saulius1005/AVR64DD32-MAIN-Controller/AVR64DD32-MAIN-Controller/StepperMotor.c

/*
 * StepperMotor.c
 *
 * Created: 2025-09-11 10:29:21
 *  Author: Saulius
 */ 
#include "Settings.h"
#include "StepperMotorVar.h"

// -------------------------
// Notice
// -------------------------
// for CL86T need swap encoder pair lines 
// -------------------------
// 86HB250-156B MOTOR		CL86T 4.1
// -------------------------
// EA+						EB+			
// EA-						EB-
// EB+						EA+
// EB-						EA-
// -------------------------

// -------------------------
// Stepper Enable / Disable
// -------------------------
void Stepper_enable() {
	if(StepperMotor.alreadyEnabled == false){
		PORTF.OUTCLR = PIN1_bm; // aktyvus LOW
		_delay_ms(300); //recomended min 200m
		StepperMotor.alreadyEnabled = true;
		StepperMotor.alreadyDisabled = false;
	}
}

void Stepper_disable() {
	if(StepperMotor.alreadyDisabled == false){
		PORTF.OUTSET = PIN1_bm; // HIGH = inactive
		_delay_ms(300); //recomended min 200m
		StepperMotor.alreadyDisabled = true;
		StepperMotor.alreadyEnabled = false;
	}
}

// -------------------------
// Stepper Start / Stop
// -------------------------
void Stepper_start() {
	if(StepperMotor.alreadyStarted == false){
		while (!(TCD0.STATUS & TCD_ENRDY_bm));
		TCD0.CTRLA |= TCD_ENABLE_bm;
		StepperMotor.alreadyStarted = true;
		StepperMotor.alreadyStoped = false;
	}
}


void Stepper_stop() {
	if(StepperMotor.alreadyStoped == false){
		while (!(TCD0.STATUS & TCD_ENRDY_bm));//
		TCD0.CTRLA &= ~TCD_ENABLE_bm;//disable counter
		StepperMotor.alreadyStoped = true;
		StepperMotor.alreadyStarted = false;
	}
}

// -------------------------
// Stepper Direction
// -------------------------
void Stepper_set_direction(bool dir) {
	if (dir != StepperMotor.lastDirection)  // if direction change (single time per cycle)
	{
		Stepper_stop();//Stop generating pulses
		if (dir)
			PORTF.OUTSET = PIN3_bm;
		else
			PORTF.OUTCLR = PIN3_bm;
		_delay_us(3); //recomended min 2us
		Stepper_start();// start generating pulses
		StepperMotor.lastDirection = dir;
	}
}

// -------------------------
// Init function
// -------------------------
void Stepper_init() {

	// Default PWM
	TCD0_init_stepper_PWM(25600, 50); // 51.2kHz, 50% duty for one motor shaft spin, so ~20s for gearbox
/*
	// Set idle states
	PORTF.OUTCLR = PIN2_bm; // pulse low
	PORTF.OUTSET = PIN1_bm; // disable
	PORTF.OUTCLR = PIN3_bm; // default direction*/
}

bool Read_Stepper_PEND(){ // true if position reached
	return !(PORTF.IN & PIN5_bm);
}

bool Read_Stepper_ALM(){ // true if driver has a error (overheat, stepepr stuck and so on)
	return !(PORTF.IN & PIN4_bm);
}

uint16_t Read_Stepper_Voltage(){
	ADC0_SetupStepper(0);
	return (ADC0_read() * 0.1775) * Stepper_Voltage_Compensation_koef;
}

int16_t Read_Stepper_Current(){
	ADC0_SetupStepper(1);
	return ((int16_t)ADC0_read() - (int16_t)Read_MCU_Voltge())/4;
}
