saulius1005/AVR64DD32-MAIN-Controller/AVR64DD32-MAIN-Controller/LinearMotor.c

/*
 * LinearMotor.c
 *
 * Created: 2025-09-09 14:20:10
 *  Author: Saulius
 */ 
#include "Settings.h"
#include "LinearMotorVar.h"

void LinearMotor_enable(){ //turn on TLE9201SG
	if(LinearMotor.alreadyEnabled == false){
		PORTD.OUTCLR = PIN2_bm;  // DIS=0
		_delay_us(5);
		LinearMotor.alreadyEnabled = true;
		LinearMotor.alreadyDisabled = false;
	}
}

void LinearMotor_disable(){ //turn off TLE9201SG
	if(LinearMotor.alreadyDisabled == false){
		PORTD.OUTSET = PIN2_bm;  // DIS=1
		_delay_us(5);
		LinearMotor.alreadyDisabled = true;
		LinearMotor.alreadyEnabled = false;
	}
}

void LinearMotor_start(){ //starting pwm signal generation
	if(LinearMotor.alreadyStarted == false){		
		TCA0.SPLIT.CTRLB |= TCA_SPLIT_HCMP0EN_bm; //connecting TCA to PD3
		TCA0.SPLIT.CTRLA |= TCA_SPLIT_ENABLE_bm; //turn on TCA back
		LinearMotor.alreadyStarted = true;
		LinearMotor.alreadyStoped = false;
	}

}

void LinearMotor_stop(){
	if(LinearMotor.alreadyStoped == false){ //stoping pwm signal generation
		TCA0.SPLIT.CTRLB &= ~(TCA_SPLIT_HCMP0EN_bm); //disconecting TCA from PD3
		TCA0.SPLIT.CTRLA &= ~TCA_SPLIT_ENABLE_bm;  // turn off TCA
		PORTD.OUTCLR = PIN3_bm; //ensure PWM low level
		_delay_ms(500); //preventing from error flag- 500mS of free spinning
		LinearMotor.alreadyStoped = true;
		LinearMotor.alreadyStarted = false;
	}

}

void LinearMotor_set_direction(bool dir)
{
    if (dir != LinearMotor.lastDirection)  // if direction change (single time per cycle)
    {
		LinearMotor_stop();
		if(dir)
            PORTD.OUTSET = PIN5_bm;   // UP
		else
            PORTD.OUTCLR = PIN5_bm;   // DOWN
		_delay_us(5);
		LinearMotor_start();
        LinearMotor.lastDirection = dir;
    }
}

void LinearMotor_init(){
	TCA0_init_linear_PWM(20000, 95);
	PORTD.OUTSET = PIN2_bm; //set output disabled for TLE9201SG
};

bool Read_LinearMotor_EF(){ // false if driver has a error (overheat, linear motor stuck and so on)
	return PORTD.IN & PIN4_bm;
}

uint16_t Read_LinearMotor_Voltage(){
	ADC0_SetupLinearMotor(0);
	return (ADC0_read() * 0.075) * LinearMotor_Voltage_Compensation_koef; // same as ADC read/2000 * 30V (300k) / 2V(AMC1131 full range) )
}

int16_t Read_LinearMotor_Current(){
	ADC0_SetupLinearMotor(1);
	return ((int16_t)ADC0_read() - (int16_t)Read_MCU_Voltge())/4;
}
