saulius1005/AVR64DD32-MAIN-Controller/AVR64DD32-MAIN-Controller/StepperMotor.h

/*
 * StepperMotor.h
 *
 * Created: 2025-09-11 10:30:32
 *  Author: Saulius
 */ 


#ifndef STEPPERMOTOR_H_
#define STEPPERMOTOR_H_

#define Stepper_Voltage_Compensation_koef 1.05 //59,62V Actual measured voltage and calculated 56,7V

typedef struct {
	bool lastDirection;
	bool alreadyStarted;
	bool alreadyStoped;
	bool alreadyEnabled;
	bool alreadyDisabled;
	uint16_t measuredVoltage;
	int16_t measuredCurrent;
	uint8_t stuckCount;
	uint8_t noChangeCount;
} HBS86;

extern HBS86 StepperMotor;


#endif /* STEPPERMOTOR_H_ */
