saulius1005/AVR64DD32-MAIN-Controller/AVR64DD32-MAIN-Controller/LinearMotorVar.h

/*
 * LinearMotorVar.h
 *
 * Created: 2025-09-09 14:37:56
 *  Author: Saulius
 */ 


#ifndef LINEARMOTORVAR_H_
#define LINEARMOTORVAR_H_

TLE9201SG LinearMotor = {
	.lastDirection = false,
	.alreadyStarted = false,
	.alreadyStoped = false,
	.alreadyEnabled = false,
	.alreadyDisabled = false,
	.measuredVoltage = 0,
	.measuredCurrent = 0,
	.stuckCount = 0,
	.noChangeCount = 0
};

#endif /* LINEARMOTORVAR_H_ */
