saulius1005/AVR64DD32-MAIN-Controller/AVR64DD32-MAIN-Controller/FOUSART.h

/*
 * FOUSART.h
 *
 * Created: 2025-09-05 11:21:40
 *  Author: Saulius
 */ 


#ifndef FOUSART_H_
#define FOUSART_H_

/**
 * @brief Maximum count for consecutive errors before marking the system as faulty.
 */
#define FO_TIMEOUT_COUNTER 400000 ///< Timeout counter value for operations if baud 460.8k
#define CountForError_FO 3
#define Angle_Precizion 100 // 100 meaning exp. 360 degree 10 3600 (360,0), 1 36000 (360,00)
#define U_I_Precizion 1 // 10 meaning 24, 1 240 (24.0)
#define MESSAGE_LENGTH_FO 17


typedef struct {
	uint16_t Elevation;
	uint16_t HPElevation;
	uint16_t Azimuth;
	uint16_t HPAzimuth;
	uint16_t PVU;
	uint16_t PVI;
	uint8_t endSwitches;
	bool ElMin;
	bool ElMax;
	bool AzMin;
	bool AzMax;
	bool FO_bad_signal_fault;
	bool FO_lost_signal_fault;
	bool FO_data_fault;
	bool FO_lost_connecton_fault;
	uint8_t FO_elevation_sensor_fault;
	uint8_t FO_azimuth_sensor_fault;
	uint8_t FO_faultcount;
	char FreshDataPack[MESSAGE_LENGTH_FO];
} FOdata;

extern FOdata SensorData;

#endif /* FOUSART_H_ */
