saulius1005/AVR64DD32-MAIN-Controller/AVR64DD32-MAIN-Controller/i2c.h

/**
 * @file i2c.h
 * @brief Header file for I2C Communication Functions
 * 
 * This header file defines constants, macros, and function prototypes for I2C communication.
 * It also defines a structure for storing the I2C status, including error codes.
 * 
 * Created: 2024-12-05 14:29:10
 * Author: Saulius
 */

#ifndef I2C_H_
#define I2C_H_


#define F_SCL 400000UL 

#define TWI_TIMEOUT_COUNTER 5000 ///< Timeout counter value for operations

#define I2C_RETRY_COUNT 3

#define TWI_BAUD ((F_CPU / (2 * F_SCL)) - 5)

#define WRITE 0 ///< Write operation flag

#define READ 1 ///< Read operation flag

#define STOP 1 ///< Stop condition flag

#define Error_None    0
#define Error_Timeout 1
#define Error_NACK    2
#define Error_Bus     3

typedef struct {
    volatile uint8_t error; ///< Error code for I2C operations
} I2C_Status;

extern I2C_Status I2C; ///< Global I2C status instance

#endif /* I2C_H_ */
