saulius1005/AVR64DD32-MAIN-Controller/AVR64DD32-MAIN-Controller/Joystick.h

/*
 * Joystick.h
 *
 * Created: 2025-09-08 12:58:50
 *  Author: Saulius
 */ 


#ifndef JOYSTICK_H_
#define JOYSTICK_H_

#define Joystick_X_axis_CH ADC_MUXPOS_AIN30_gc //dependet  from GPIO.c settings
#define Joystick_Y_axis_CH ADC_MUXPOS_AIN29_gc //dependet  from GPIO.c settings
#define Joystick_steps 500 //how many steps in one axis. 1000 means 5 (4 + step at 0 = 5), exp: 500 = 9, 2000 = 3 and so on.

typedef struct {
	int16_t X_Axis;
	int16_t Y_Axis;
	uint8_t Button;
	bool LastState;
	uint8_t LatchSwitch;
	uint8_t window;
} ADCJoy;

extern ADCJoy Joystick;

#endif /* JOYSTICK_H_ */
