saulius1005/AVR64DD32-MAIN-Controller/AVR64DD32-MAIN-Controller/JoystickVar.h

/*
 * JoystickVar.h
 *
 * Created: 2025-09-08 12:59:06
 *  Author: Saulius
 */ 


#ifndef JOYSTICKVAR_H_
#define JOYSTICKVAR_H_

ADCJoy Joystick = {
	.X_Axis = 0,
	.Y_Axis = 0,
	.Button = 0,
	.LastState = false,
	.LatchSwitch = 0,
	.window = 0
};



#endif /* JOYSTICKVAR_H_ */
