saulius1005/AVR64DD32-MAIN-Controller/AVR64DD32-MAIN-Controller/windowsVar.h

/*
 * windowsVar.h
 *
 * Created: 2025-01-26 23:35:50
 *  Author: Saulius
 */ 


#ifndef WINDOWSVAR_H_
#define WINDOWSVAR_H_

screenShow show = {
	.window = 0,
	.lastWindow = 0
};

#endif /* WINDOWSVAR_H_ */
