saulius1005/AVR64DD32-MAIN-Controller/(commit log)

2025-09-07 Function test at first
    screen working, FO also, Attiny212 part working great, now filtering and processing received data from Top controller trough FO
2025-09-08 Joystick functions
    Added basic Joystick functions. Now MCU reads X, Y axis ADC values and also reads Button status. ADC don't work if Multivoltage pins are enabled in MCU fuses settings
2025-09-09 RS485 communication test
    First data receiving test and its work!!! through ~12m cable
2025-09-09 Linear motion test
    its work but with strange behavior. Need to found bug.
    [CLK.c, FOUSART.c, FOUSART.h, FOUSARTVar.h, GPIO.c, LinearMotor.c, LinearMotor.h, LinearMotorVar.h]
2025-09-09 linear motor test success
    bug found- after TCA disabling also need to disconect it from a PD3 pin and only then change direction. After that connect back PD3 and turn on TCA
    [LinearMotor.c, main.c]
2025-09-10 Linear motor action logic
    closed loop function already work, now need to fix a function version which one is not in closed loop (fault detection logic need to be fixed)
    [FOUSART.c, FOUSART.h, FOUSARTVar.h, LinearMotor.c, LinearMotor.h, LinearMotorVar.h, Settings.h]
2025-09-12 Stepper control
    Added and tested stepper control functions. It works at 40kHz using TCD timer HBS86 driver settings also is Pulse/rev = 40000
2025-09-12 Linear and Stepper basic functions completed
    Both linear (elevation) and stepper (azimuth) motors basic controlling functions are completed. enable, disable, start, stop, set direction and init
2025-09-12 EF status fixed
    EF on TLE9201 active when signal is high not when low!
    [LinearMotor.c, Settings.h, StepperMotor.c, main.c]
2025-09-12 Stepper and Linear motors Voltage and Current reading
    Added and tested Voltage and Current reading functions. After test in main function changed Azimuth and elevation motors controlling sequence.
2025-09-12 fixed lost communication freezing
    added timeout exit for FO and RS485 data reading functions
    [FOUSART.c, FOUSART.h, FOUSARTVar.h, GPIO.c, LinearMotor.h, LinearMotorVar.h, RS485USART.c, RS485USART.h]
2025-09-14 fixed high frequency noise
    noise come from HBS driver. Fault was in dummy RS485 data transmitter.
    [FOUSART.c, RS485USART.c, main.c]
2025-09-14 Fixed TCD stepeper controll
    Changed TCD control according to datasheet. before enabling and disabling counter need to wait synchronization and something about CCP protection.
    [FOUSART.c, FOUSART.h, FOUSARTVar.h, StepperMotor.c]
2025-09-16 HLTNC HBS86 driver is TRASH!!!!
    already 3 died.... one after connection also burn down 60V psu, second works most of testing time ~ 4 days. After from nowhere high frequency noise (all signals to driver was correct ) now it shows 1 blink error without reseting, third died after half day, fault similar partialy to first and second. Motor spins to one side as usual at normal speed, then from nowhere high frequency noise and it stops- no life from it at all, but at least not burn PSU. After fast check it shorted inside at high voltage side. Now i will order CL86T 4.1 and hope it will work fine. (in my opinion no matter how bad sihnals sending to driver it should rather show some error not burn!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
    [FOUSART.c, FOUSART.h, FOUSARTVar.h, Settings.h, StepperMotor.c, USART.c]
2025-09-19 First version of properly working motor controls logic
    I just finished writing a common function for both the linear and stepper motors, which controls both motors in the same way. This common function is based on the LinearMotorControl() function, which was successfully tested. Still not tested with stepper motor- waiting new drivers to arrive
2025-09-20 UI update
    Added voltage and current measurements for both motors in motors controlling function also added 2nd window for electrical parameters viewing.
2025-09-22 Added Manual Control
    Also fixed an issue where, after losing the Fiber Optic data connection, the error message would not reset automatically.
    [FOUSART.c, FOUSART.h, FOUSARTVar.h, Joystick.c, Joystick.h, JoystickVar.h]
2025-10-01 UI + RS485 errors + startup actions
    Changed user interface: main window by adding more error messages from RS485 network (Weather Station). Also edited main loop for first start actions (No longer movement before data collection)
    [ActionsVar.h, FOUSART.h, RS485USART.c, RS485USART.h, Windows.c, main.c, windows.h]
2025-10-10 Changed manual motors control
    Slowed down the stepper speed (hardware settings for the CL86T remain the same — 51,200 pulses/rev) to 12,800 (4× slower). Before the gearbox, one full rotation took 20 seconds; now it should take about 80 seconds. Completely rewrote the manual motor control for both motors.
2025-10-10 Voltage and Current reading
    Changed the voltage and current readings for both motors - electrical parameters are now monitored continuously instead of only when the motors are running.
2025-10-10 Changes in main window
    In manual mode, instead of error messages in the min window, electrical motor data is now displayed. In auto mode, everything remains unchanged.
    [Windows.c, windows.h]
2025-10-18 End Switches, bug fixes
    Included end switch logic into the motor control logic. You can now see the end switch values on the 7th line of the screen (it shows only when a switch is active; otherwise, the 7th line remains empty). The code still contains old drafts (commented out).
    [ActionsVar.h, FOUSART.c, FOUSART.h, FOUSARTVar.h, LinearMotor.c, Windows.c]
2025-10-25 Linear motor duty cycle 80%->99%
    After testing, it was able to lift the SunFlower solar panel frame only when the duty cycle was set to 80%. After all solar panels were installed, it could no longer lift the entire frame from the vertical position without any help. 99% duty cycle still not tested
    [LinearMotor.c]
2025-11-06 Changes after field test (auto mode)
    During field testing in auto mode, the screen was flickering, showing random symbols, and occasionally freezing.
    Regarding motion: when the system needs to travel a longer distance or when both motors operate simultaneously, an error occurs.
    Temporary solution: added a “motor stuck” flag (error code) to help determine the root cause whether the motor is spinning too fast or getting stuck.
    I will test the updated version tomorrow (2025-11-05).
    [ActionsVar.h, FOUSART.h, FOUSARTVar.h, USART.c, Windows.c, i2c.c]
2025-11-07 Auto mode work*
    I am still testing this version, but it seems to work, at least for now.
    In the automatic motor control function in Actions.c, I added a startup delay and defined the operating range for azimuth and elevation angles (minimum and maximum limits).
    I also fixed the screen flickering issue (added a 10 µF capacitor between the screen’s VCC and GND) and added an additional 680 µF 6 V capacitor on the bottom (power) PCB.
    Changes were also made in the I2C and display control functions
    [ActionsVar.h, GPIO.c]
2025-11-07 Fine-tuning
    stepper-azimuth sensor measuring start delay was 100 (50*2), now 200 (50*4)
2025-11-07 Start delay is reset when the target is reached.
    Start delay is reset when the target is reached. Added start delay reset when the target is reached, because when the platform stops, the wind moves it slightly in both directions. As a result, when motion starts again, sensor backlash appears and needs to be compensated once more.
2025-11-07 More adjustments and an emergency stop
    More adjustments and an emergency stop. Added an emergency stop function whose purpose is to stop both motors when the connection to the weather station or the top controller is lost, or when the top controller is not sending data or the data is faulty (SensorData.FO_bad_signal_fault). When it hapens faultFlag = 4
2025-11-07 stuck detection at backlash range
    Fixed issue where startDelay didn’t reset after the target was reached (in backlash range)
    [Windows.c]
2025-12-08 Actions when is too dark
    Now, when it is too dark, the tower does not rotate to the day-top elevation and azimuth angles. It stays in the last position (saving power). The ‘Day Top Elevation’ variable has been removed.
2025-12-08 CRC error fix
    Fixed a CRC error that occurred due to an overly long total message length and an incorrect CRC check size (it was validating 9 bytes instead of 7).
    [CRC.c, RS485USART.h]
2025-12-09 Code update for the upcoming data logger.
    After receiving the sun coordinates and other parameters from the meteorological station, the towers send the platform’s elevation and azimuth angles, as well as all electrical parameters (solar panels, stepper, and linear motors) to the future data logger. Communication loss detection has been improved using the RTC. Each tower now has its own ID number (settings.h)
2025-12-10 Optimization in data receive from Top controller part
    It is mostly in FOUSART.c, but now the device also displays the ID number on the screen.
